krzysztofbrzozowski/weather_station_ESP8266/hardware/housing/case_bottom.obj

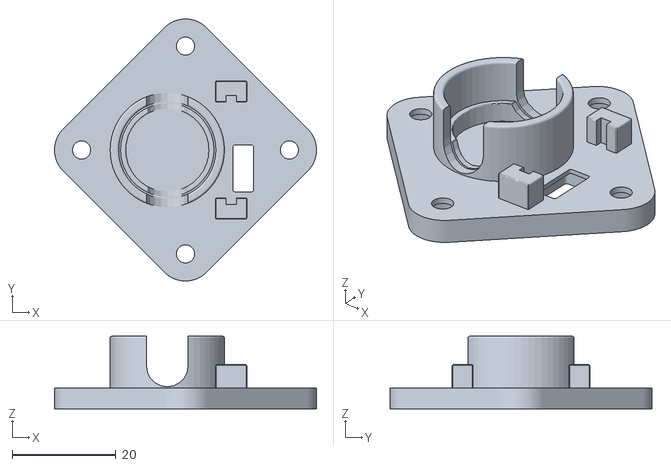
[picture p1: CAD file, 2026-10-16]
hardware/housing/case_bottom.obj
50.4 x 50.4 x 14.0
