krzysztofbrzozowski/weather_station_ESP8266/hardware/housing/case_top.obj

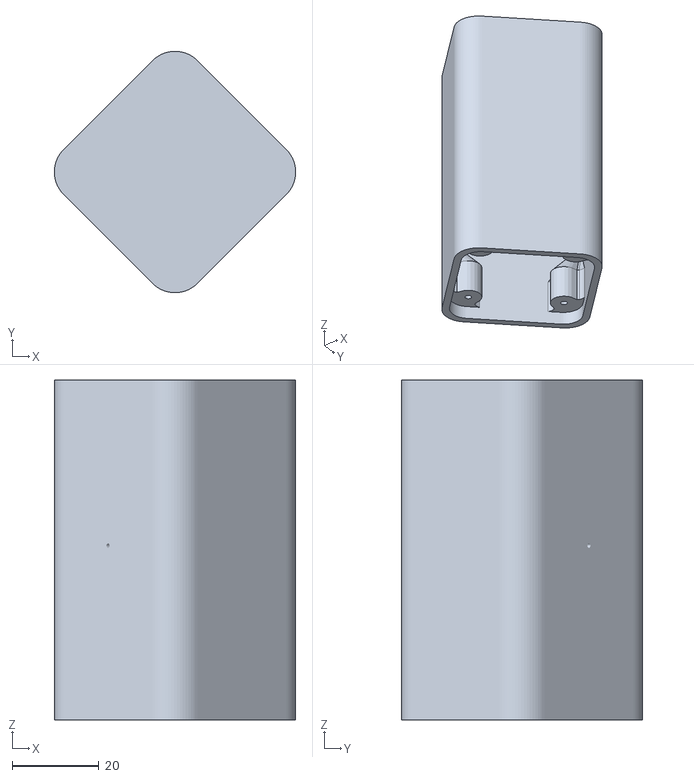
[picture p2: CAD file, 2026-10-16]
hardware/housing/case_top.obj
55.7 x 55.7 x 78.5
