krzysztofbrzozowski/weather_station_ESP8266/schematic/weather_station v1.pdf

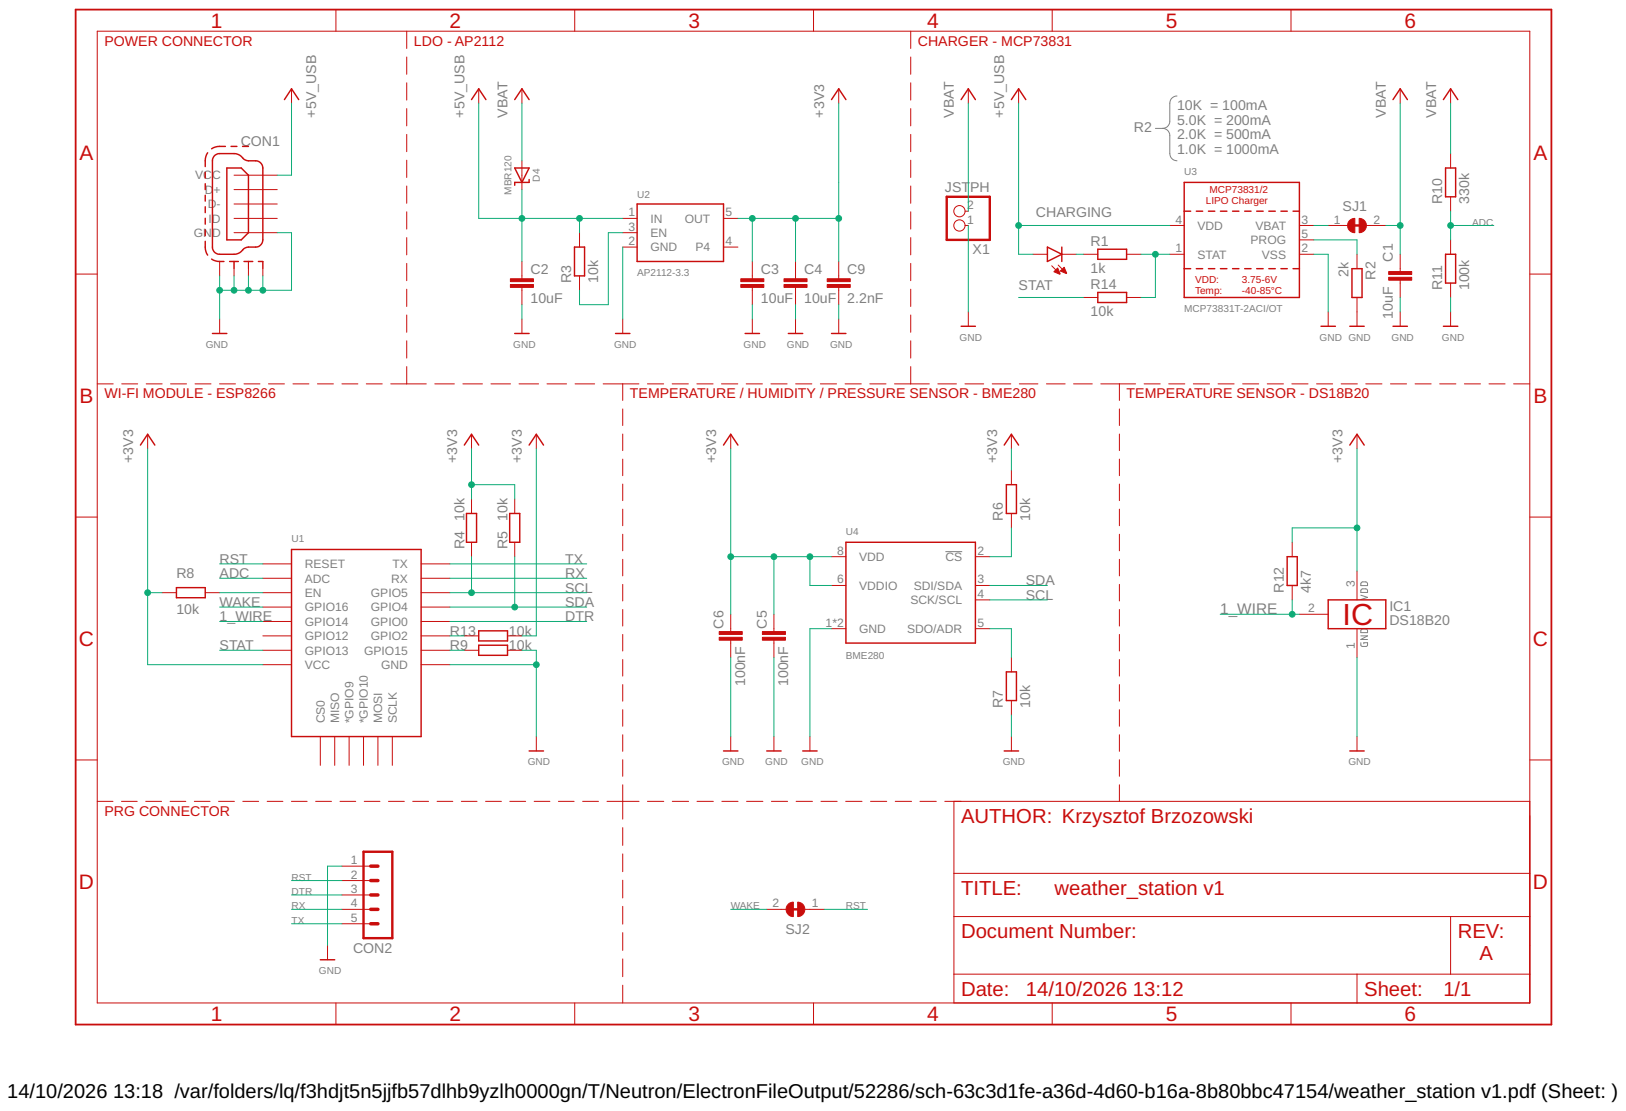
[picture p3: page 1]

TEMPERATURE / HUMIDITY / PRESSURE SENSOR - BME280

Document Number: | REV: A

Date: 14/10/2026 13:12 | Sheet: 1/1

14/10/2026 13:18 /var/folders/lq/f3hdjt5n5jjfb57dlhb9yzlh0000gn/T/Neutron/ElectronFileOutput/52286/sch-63c3d1fe-a36d-4d60-b16a-8b80bbc47154/weather_station v1.pdf (Sheet: )
