krzysztofbrzozowski/weather_station_ESP8266/hardware/sch_pcb/weather_station.brd

## EAGLE design hardware/sch_pcb/weather_station.brd (2026-10-16)

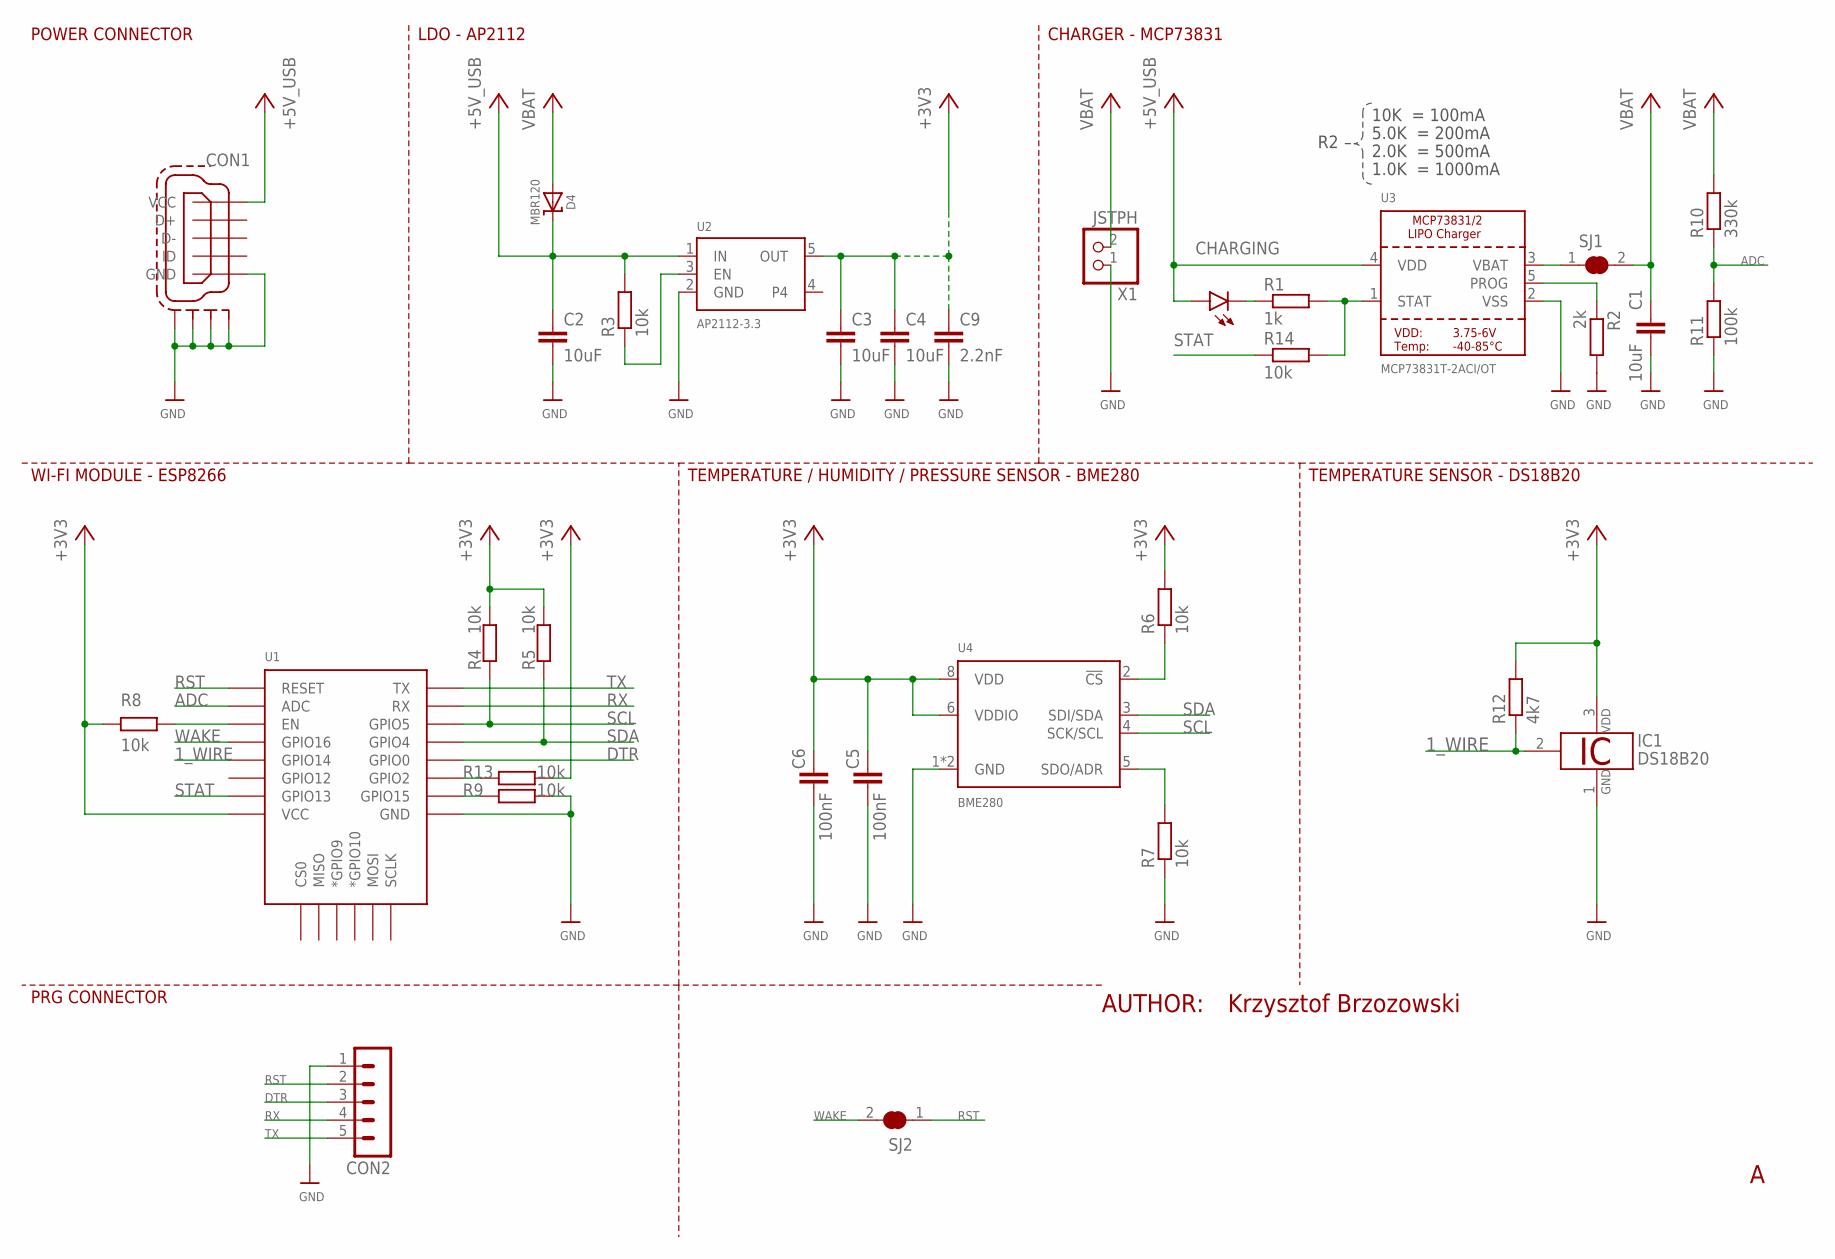
[picture p4: schematic weather_station.sch]

Parts:
C1, C2, C3, C4: 10uF; C1210
C5, C6: 100nF; C0402K
C9: 2.2nF; C0402K
CHARGING: LEDCHIPLED_0603; CHIPLED_0603
CON1: MICROUSB-MOLEX
CON2: MA05-1
D4: MBR120; SOD-123
IC1: DS18B20; TO92-LNG
R1: 1k; R0402
R2: 2k; R0402
R3, R4, R5, R6, R7, R8, R9, R13, R14: 10k; R0402
R10: 330k; R0402
R11: 100k; R0402
R12: 4k7; R0402
SJ1, SJ2: SOLDERJUMPER_CLOSED; SOLDERJUMPER_CLOSEDWIRE
U1: ESP12ESMD; ESP12E-SMD
U2: AP2112-3.3; SOT23-5
U3: MCP73831T-2ACI/OT; SOT23-5
U4: BME280; LGA-8-2.5X2.5
X1: JSTPH; JSTPH2

Connections:
1_WIRE: IC1.2 (1W), R12.1, U1.GPIO14
+3V3: C3.1, C4.1, C5.1, C6.1, C9.1, IC1.3 (VDD), R4.2, R5.2, R6.2, R8.2, R12.2, R13.1, U1.VCC, U2.5 (OUT), U4.6 (VDDIO), U4.8 (VDD)
+5V_USB: C2.1, CHARGING.A, CON1.VCC, D4.C, R3.2, U2.1 (IN), U3.4 (VDD)
ADC: R10.1, R11.2, U1.ADC
DTR: CON2.3, U1.GPIO0
EN: R3.1, U2.3 (EN)
GND: C1.2, C2.2, C3.2, C4.2, C5.2, C6.2, C9.2, CON1.GND, CON1.GND_H_00 (SH1), CON1.GND_H_01 (SH2), CON1.GND_H_02 (SH3), CON1.GND_H_03 (SH3), CON1.GND_H_04 (SH3), CON1.GND_H_05 (SH3), CON1.GND_H_06 (SH3), CON1.GND_H_07 (SH3), CON1.GND_H_08 (SH3), CON1.GND_H_09 (SH3), CON1.GND_H_10 (SH3), CON1.GND_H_11 (SH3), CON1.GND_H_12 (SH3), CON1.GND_H_13 (SH4), CON1.GND_H_14 (SH4), CON1.GND_H_15 (SH4), CON1.GND_H_16 (SH4), CON1.GND_H_17 (SH4), CON1.GND_H_18 (SH4), CON1.GND_H_19 (SH4), CON1.GND_H_20 (SH4), CON1.GND_H_21 (SH4), CON1.GND_H_22 (SH4), CON1.GND_H_23 (SH4), CON1.GND_P_0 (SH3), CON1.GND_P_1 (SH3), CON1.GND_P_2 (SH4), CON1.GND_P_3 (SH4), CON2.1, IC1.1 (GND), R2.2, R7.1, R9.1, R11.1, U1.GND, U2.2 (GND), U3.2 (VSS), U4.1 (GND), U4.7 (GND), X1.1
unnamed: CHARGING.C, R1.1
unnamed: SJ1.1, U3.3 (VBAT)
unnamed: R1.2, R14.2, U3.1 (STAT)
unnamed: R2.1, U3.5 (PROG)
unnamed: R6.1, U4.2 (!CS)
unnamed: R7.2, U4.5 (SDO/ADR)
unnamed: R13.2, U1.GPIO2
unnamed: R8.1, U1.CH_PD (EN)
unnamed: R9.2, U1.GPIO15
RST: CON2.2, SJ2.1, U1.RESET
RX: CON2.4, U1.RXD0 (RX)
SCL: R4.1, U1.GPIO5, U4.4 (SCK/SCL)
SDA: R5.1, U1.GPIO4, U4.3 (SDI/SDA)
STAT: R14.1, U1.GPIO13
TX: CON2.5, U1.TXD0 (TX)
VBAT: C1.1, D4.A, R10.2, SJ1.2, X1.2
WAKE: SJ2.2, U1.GPIO16

Notes on the sheet:
10K = 100mA
5.0K = 200mA
2.0K = 500mA
1.0K = 1000mA
AUTHOR:
Krzysztof Brzozowski
TEMPERATURE / HUMIDITY / PRESSURE SENSOR - BME280
POWER CONNECTOR
LDO - AP2112
CHARGER - MCP73831
WI-FI MODULE - ESP8266
TEMPERATURE SENSOR - DS18B20
PRG CONNECTOR

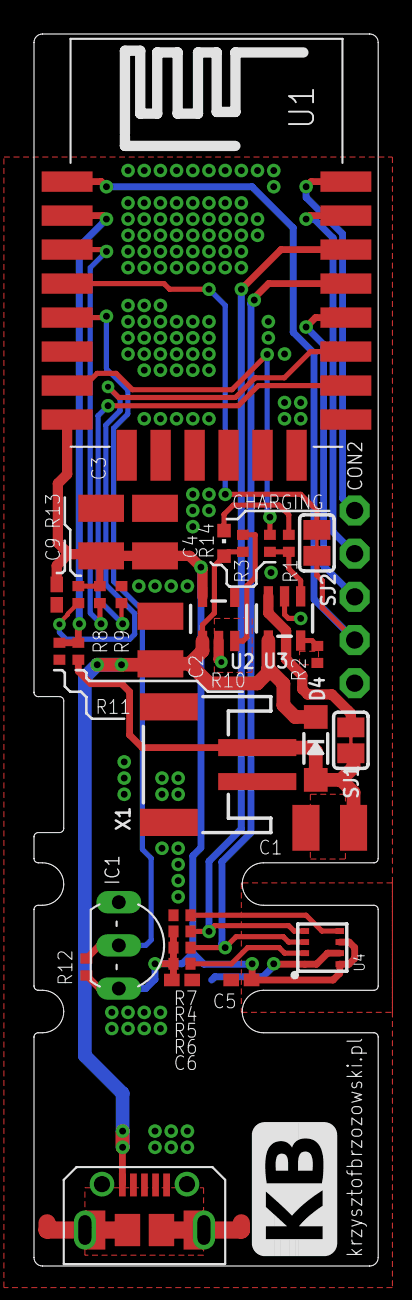
[picture p5: board weather_station.brd from above]

Board: 2 copper layers, 20.2 x 72.5 mm, 33 parts (0 on the bottom side), 24 nets.
