krzysztofbrzozowski/weather_station_ESP8266/(commit log)

2026-10-14 feat: Added Arduino version -> uPython not supporting proper tls
2026-10-16 doc: Schematic added
